llllgt/openhand-t42-structural-design/docs/工程来源.md

# 工程来源与参数依据

查阅日期：2026-10-26。原始 STEP、来源版本与新增研究参数分开记录。没有把网页中其他配置的产品性能直接当作本项目性能。

| 来源 | 本项目使用的信息 | 引用位置 |
|---|---|---|
| [Yale T42](https://www.eng.yale.edu/grablab/openhand/model_t42.html) | 双指、独立驱动及可选机构版本 | 机构对象 |
| [T42 1.0 装配指南](https://www.eng.yale.edu/grablab/openhand/model%20t42/Fabrication%20-%20Model%20T42%201.0.pdf) | 支座/指节关系、6.35 mm 销及卷线件安装；PDF 第 9–14、18 页 | 上部装配、走线假设 |
| [Finger Guide](https://www.eng.yale.edu/grablab/openhand/OpenHand%20Finger%20Guide.pdf) | 腱绳单向驱动、回位元件、不同销孔后加工用途 | 机构及工艺 |
| [CAD Guide](https://www.eng.yale.edu/grablab/openhand/OpenHand%20CAD%20Guide.pdf) | 名义近/远杆长 62.5/37.5、传动半径 8、打印补偿概念 | 名义参数；近端杆长另由 STEP 核对 |
| [ROBOTIS MX-28](https://emanual.robotis.com/docs/en/dxl/mx/mx-28/) | 12 V 堵转转矩 2.5 N·m、空载转速 55 rpm；二者不是持续带载额定值 | 候选规格核对 |
| [EOS PA2200 Balance](https://www.eos.info/polymer-solutions/data-sheets/pds-pa-2200-balance) | 干态模量、方向相关试样强度、密度 | 材料路线与新增 FE 的 E 值参考 |
| [Prusament PETG 数据表](https://storage.googleapis.com/prusa3d-content-prod-14e8-wordpress-prusament-prod/2023/10/9f8d2165-tds_prusament-petg_n_en.pdf) | 试样模量、密度及与打印条件相关的限制 | 试块与装配样件材料比较 |

本地查阅用的三份 Yale PDF 下载至 `E:/Codex/downloads/openhand-reference`，不把外部完整文档复制进发布仓库。校验值：

| 本地文件 | SHA-256 |
|---|---|
| t42-assembly.pdf | bbc0f198c3fa30a37c703ab408299d73618d76459fed0337bd78c9f26cb46719 |
| finger-guide.pdf | 9a18d65482ab79757810bedcfe1d9b31c045f5618501b047b8b66b2d0a48b105 |
| cad-guide.pdf | ede1a6f447741767c93c3a924a36c4e789cd69b2b885e2a643f10128c9546cdd |

关键 STEP 的固定上游提交：`b10197dcd79e7bcfa92c6d5a0bfa479e6a789fba`。源文件 Git blob 哈希见 `source_manifest.json`，原始文件校验见 `upstream_checksums.json`。

本项目自行设定、不可冒充原装或实测参数的项目：接触位置/法向与闭合约束、等效弹簧刚度、传动效率、目标接触力、载荷系数、成品公差、弹性支承刚度、泊松比和验收阈值。完整输入见 `engineering.json`。

原始与派生 CAD 继续保留 Yale OpenHand 的署名及 CC BY-NC 3.0 要求。源机构与新增分析/改型的责任边界见仓库 README 与许可文件。
