llllgt/openhand-t42-structural-design/docs/设计与验证说明.md

# T42 手指支承顶板：设计与验证说明

> 本文件保留 **Rev A 初版** 的参数与结果。当前 **Rev B** 已增加机构/传力分析、装配与公差修订、材料工艺方案及新的等效载荷计算。现行入口见 [机构与传力分析](机构与传力分析.md)、[装配公差与工艺](装配公差与工艺.md) 和 [新增结构验证](新增结构验证.md)。Rev B 顶板体积减少约 5.07%；下文的 1.8 mm / 5.53% 仅属于旧版。

本项目独立于四自由度机械臂项目。交付对象为 OpenHand T42 的一个承载零件及其数值验证，不宣称重新设计了整套欠驱动手。

## 设计输入

- 上游：Yale OpenHand / grablab/openhand-hardware。
- 固定版本：`b10197dcd79e7bcfa92c6d5a0bfa479e6a789fba`。
- 原始零件：`model t42/step/a1_p_t42.STEP`，即 Pivot-Flexure / Pivot-Pivot 手指方案共用的顶板。其来源与装配用途可对照官方 T42 1.0 装配指南第 10 页内容（PDF 第 11 页）。
- 原始零件包围盒 109 × 88 × 9 mm，中央底板名义厚度 3 mm。原 STEP 下表面为 Z = -2.997 mm，中央上表面为 Z = 0.003 mm；保留这个原始坐标偏移。
- 原始 STEP 孔、配合槽和外周定位结构保留；修改只在中央 X ±13 mm、Y ±29 mm 范围内去除材料。通过布尔差验证范围外移除体积为零，新增体积为零。

## 方案取舍

中央区域设置四个 10 × 24 mm、平面角 R2 的凹槽，中心为 (±7, ±16) mm，朝原底面开口。X 方向保留 4 mm 中央连接带，Y 方向保留 8 mm 中央连接带。考察深度 1.0、1.8、2.4 mm，分别保留 2.0、1.2、0.6 mm 底厚。

1.2 mm 最小底厚和 10% 最大柔度增加是本项目预设的设计筛选规则，不是已通过实物验证的生产标准。2.4 mm 方案因剩余底厚过小，在几何筛选阶段排除。1.0 mm 为保守备选，1.8 mm 为重点验证候选。

凹槽不增加包络，可减少新增几何干涉风险；这不等于完成了整个手指机构的运动干涉检查。减去材料可能削弱局部刚度，也可能改变打印支撑、翘曲与装配表现，需要验证。

## 三种参考载荷

顶板上四条座面位于 Z = 0.003 mm，每条宽约 4 mm、长 31.9 mm。两侧座面中心 X 为 ±18.85、±43.75 mm。使用实际 STEP 座面上的面积分布载荷，而非将力施加在一个节点。

| 工况 | 施加方式 | 用途 |
|---|---|---|
| V：竖向 | 每侧两条座面合计 -10 N，整板 -20 N | 参考竖向承载 |
| S：撑开 | 左侧 -10 N X，右侧 +10 N X | 参考平面内传力 |
| M：相反弯矩 | 每侧内外座面施加 ±(500/24.9) N 的 Z 向力偶 | 每侧约 500 N·mm、左右方向相反的参考弯矩 |

四处安装孔的圆柱壁全固定，孔中心 (±23, ±35) mm，源模型孔半径为 2.2479 mm。该边界代表理想刚性夹紧，未包含螺钉预紧、支柱柔性、孔隙或摩擦接触。孔位和孔径源自 STEP 几何，不能把原模型孔径当作已确定的加工公差。

这些载荷是零件级对比工况，不是通过完整腱绳-手指静力学推导得到的工况。特别是 500 N·mm 不能直接换算为整手的额定抓取力或负载能力。

## 材料与求解方法

- 假定均质、各向同性、线弹性聚合物：E = 2000 MPa，泊松比 0.35，密度 1.20 g/cm³。
- 这些参数是比较方案的统一假设，不是任何具体打印牌号或方向的实测参数。几何体积变化可靠；质量为全实体同密度估算，不能视为打印机切片后的用料或称量结果。
- CAD：CadQuery / OpenCascade。网格：Gmsh。有限元：scikit-fem 二次四面体位移单元（P2），在一阶直边几何上计算；线性系统由 SciPy 求解。
- 初步一阶四面体计算显示薄壁弯曲结果对网格敏感，所以最终报告使用二次单元，保留较粗及细化两档网格对照。
- 梁算例采用端面均布力、全固定根部，与含剪切变形的 Timoshenko 梁公式比较。有限元端面平均挠度以载荷做功除以总力得到。
- 对每次求解检查自由自由度残差、总力平衡、总力矩平衡；保留网格、角点位移和单元平均等效应力的数据。

报告中的“最大位移”限定为网格角点采样最大值。应力图显示单元内积分得到的平均 von Mises 应力；表中的最大单元值并不等于连续应力场的峰值。固定孔边缘和几何尖角可能出现应力奇异性，不能用局部峰值推导材料安全系数。

柔度采用 C = Fᵀu（单位 N·mm），对比在同工况下使用 C_new/C_base - 1。该量衡量载荷方向上的整体变形代价；其倒数变化才对应等效刚度变化，不把柔度增加直接写成相同百分比的刚度下降。

## 工艺与图纸

修改图说明凹槽位置、尺寸、圆角、深度和剩余底厚，未修改细节以原始 STEP 为准。凹槽深度初拟为 1.8 mm（上偏差 0，下偏差 -0.15 mm），并要求检验实际剩余底厚不小于 1.2 mm；其他非配合凹槽尺寸初拟 ±0.15 mm。原始底板厚度的制造偏差也必须计入，不能只测凹槽深度。这些公差需要制造验证，不能由 CAD 精度替代。

当前没有选定材料牌号、打印方向、填充率和完整后处理工艺，因此图纸为设计评审图，不能作为生产放行图。STEP 可导入 SolidWorks / Workbench，但本项目没有在这两个软件内重建特征树或执行求解。

## 实物验证建议

制作同批材料、同打印方向的原始与修改件；测量安装孔和定位槽、称重；在相同夹具和载荷下比较座面位移。随后检查反复装拆、腱绳磨损、温升和持续载荷下的蠕变。完成这些步骤后，才能建立实际工艺公差与允许载荷。

## 来源

- [上游仓库](https://github.com/grablab/openhand-hardware)
- [T42 官方页面](https://www.eng.yale.edu/grablab/openhand/model_t42.html)
- [T42 1.0 装配指南](https://www.eng.yale.edu/grablab/openhand/model%20t42/Fabrication%20-%20Model%20T42%201.0.pdf)
- [上游许可](https://github.com/grablab/openhand-hardware/blob/master/LICENSE.md)
