llllgt/openhand-t42-structural-design/docs/新增结构验证.md

# Rev B 新增结构验证

本版的材料、载荷和凹槽深度与 Rev A 不同，结果不得交叉比较。使用二次四面体位移单元和一阶几何。研究输入为 PA2200 参考 E=1650 MPa、假设 ν=0.35；上部机构推导的合力/合矩乘 1.5 后，以四座面等效牵引加载。未求解真实上下板接触分载。

## 刚性支承对照

| 模型 | 体积 mm³ | P2 节点采样最大位移 mm | 柔度 N·mm |
|---|---:|---:|---:|
| 原始 | 30774.924 | 0.482567 | 29.398631 |
| Rev B | 29213.586 | 0.497923 | 30.464589 |

体积减少 **5.07%**；柔度增加 **3.63%**，对应本载荷模式等效刚度变化 **-3.50%**。这不是整手减重或强度提高。

## 网格复核

| 模型 | 粗/细单元数 | 柔度变化 | 全域单元应力最大值变化 | 中央区域单元应力最大值变化 |
|---|---|---:|---:|---:|
| baseline | 17262 / 25458 | 0.660% | 26.32% | -15.14% |
| revB | 21162 / 32069 | 0.588% | 6.11% | 12.37% |

目标网格尺寸 3.0→2.4 mm；柔度变化上限按百分比向上保留两位，报告为 **≤0.66%**。局部应力指标没有同等稳定，不能据此声称峰值应力收敛或强度已达标。保留应力数据用于定位和后续验证，不给安全系数。中央区域仅按单元中心 |X|<13、|Y|<29 定义，不是人为选出的“已通过”强度区域。

## 支承敏感性

| 支承 | P2 节点采样最大位移 mm | 柔度 N·mm | 相对刚性支承柔度增幅 |
|---|---:|---:|---:|
| 孔壁全固定 | 0.497923 | 30.464589 | 0.00% |
| 孔壁弹性支承 k=100.0 N/mm³ | 0.809434 | 47.044221 | 54.42% |
| 孔壁弹性支承 k=10.0 N/mm³ | 1.272445 | 71.599843 | 135.03% |

弹性支承采用孔壁三向分布弹簧：K_total=K_solid+∫k NᵀN dA。k=100/10 是探索边界敏感性的假设值，没有映射为某个真实螺钉或支柱。柔度差异说明支承模型对绝对变形影响很大；不能把全固定结果当成未经校准的实物预测。弹性支承工况只计算 Rev B，不把它与全固定原始件作改型优劣比较。

固定边界、相同泊松比下，线弹性位移随 1/E 缩放。E=1000–2200 MPa 的敏感性值也列入摘要；这个解析缩放只用于固定边界，不套用到材料与支承相对刚度同时改变的情形。

## 检查与数据定义

每个算例验证了：左右分区合力/合矩、总力与总力矩平衡、自由度残差，以及外力功/2=实体应变能+支承弹簧能。二次节点最大值包含顶点与边中点，仍是节点采样，不是连续位移场极值的严格证明。云图只绘制角点位移，明确标注。

应力值为单元积分平均值；圆角、凹槽交线、固定边界及载荷转换区可能产生强梯度。未建立完整材料许用值、螺栓预紧或疲劳模型。销轴/耳板另做解析需求筛查，见装配公差文档。

原始六组网格、位移和应力数组在 `results/engineering/fea/raw-revB.zip`，SHA-256 见同目录 `raw_checksums.json`。结果摘要与全部假设见 `results/engineering/summary.json`。该报告明确记录不确定性，而不是以应力云图代替验证结论。
