llllgt/openhand-t42-structural-design/assets/boundary_conditions.png

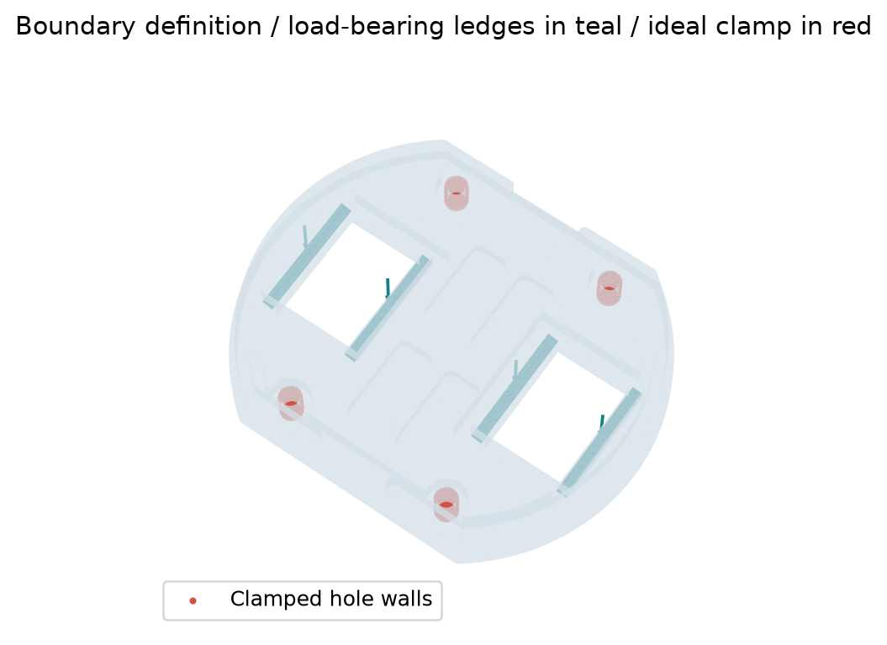
assets/boundary_conditions.png
