llllgt/openhand-t42-structural-design/assets/design_comparison.png

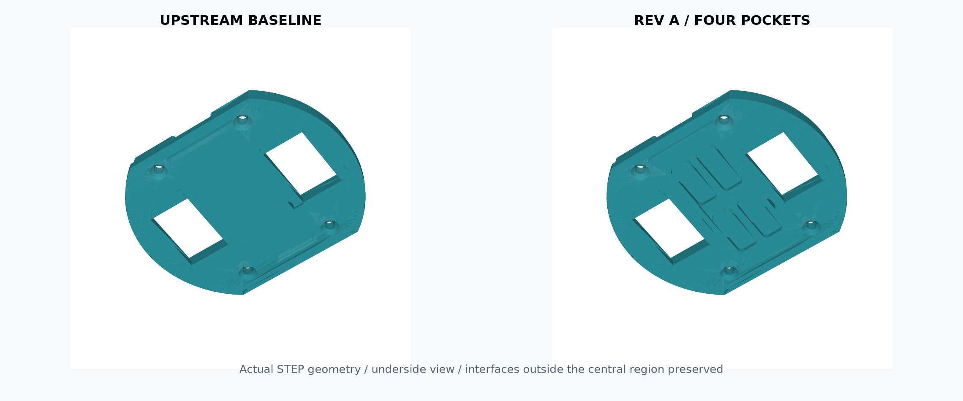
assets/design_comparison.png
