llllgt/openhand-t42-structural-design/assets/displacement_field.png

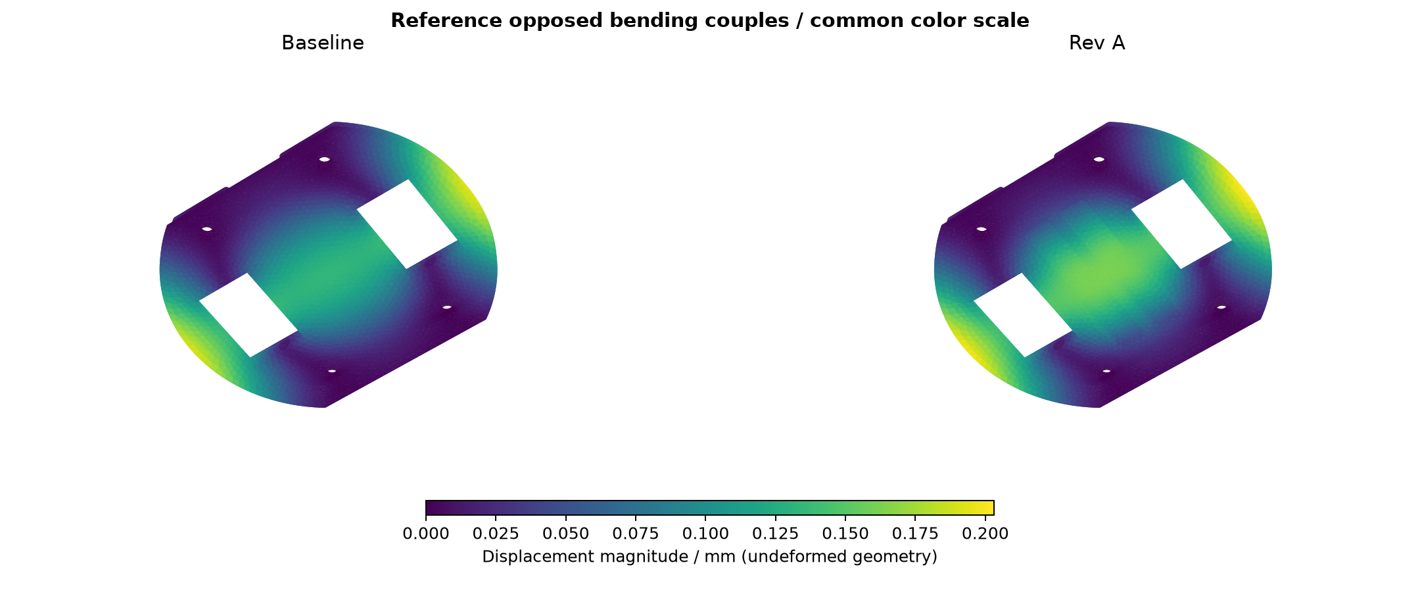
assets/displacement_field.png
