llllgt/openhand-t42-structural-design/assets/engineering_displacement.png

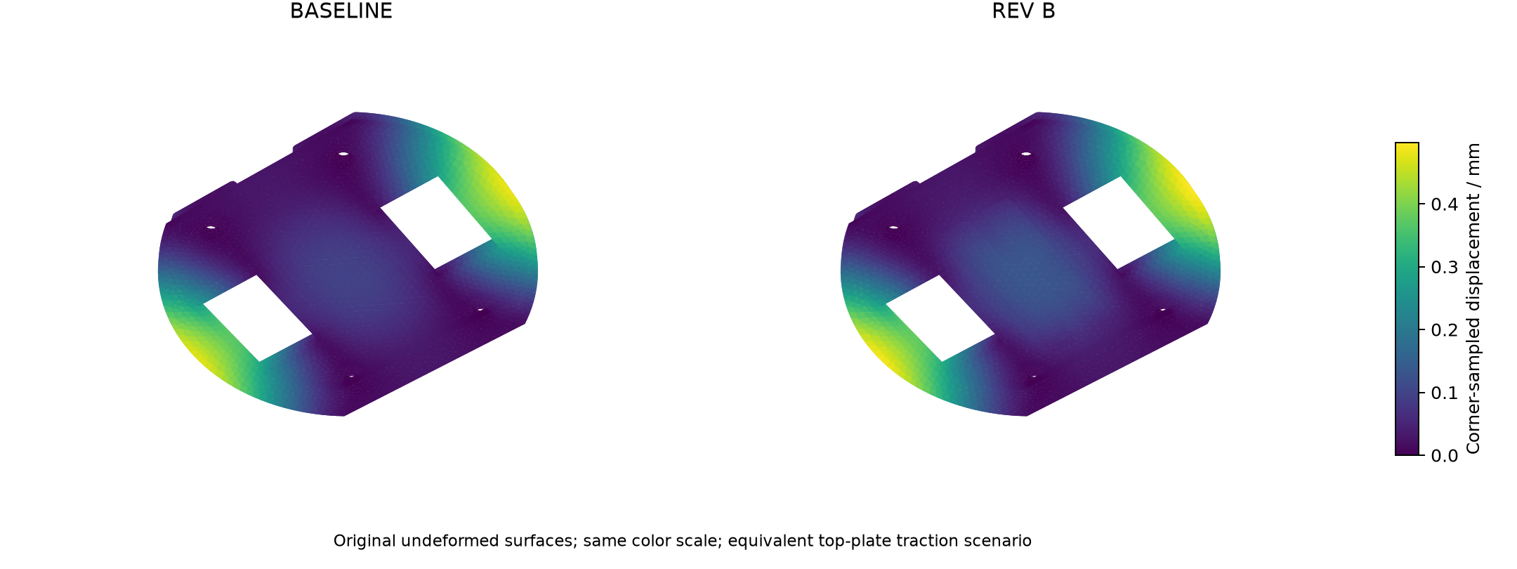
assets/engineering_displacement.png
