llllgt/openhand-t42-structural-design/assets/fea_comparison.png

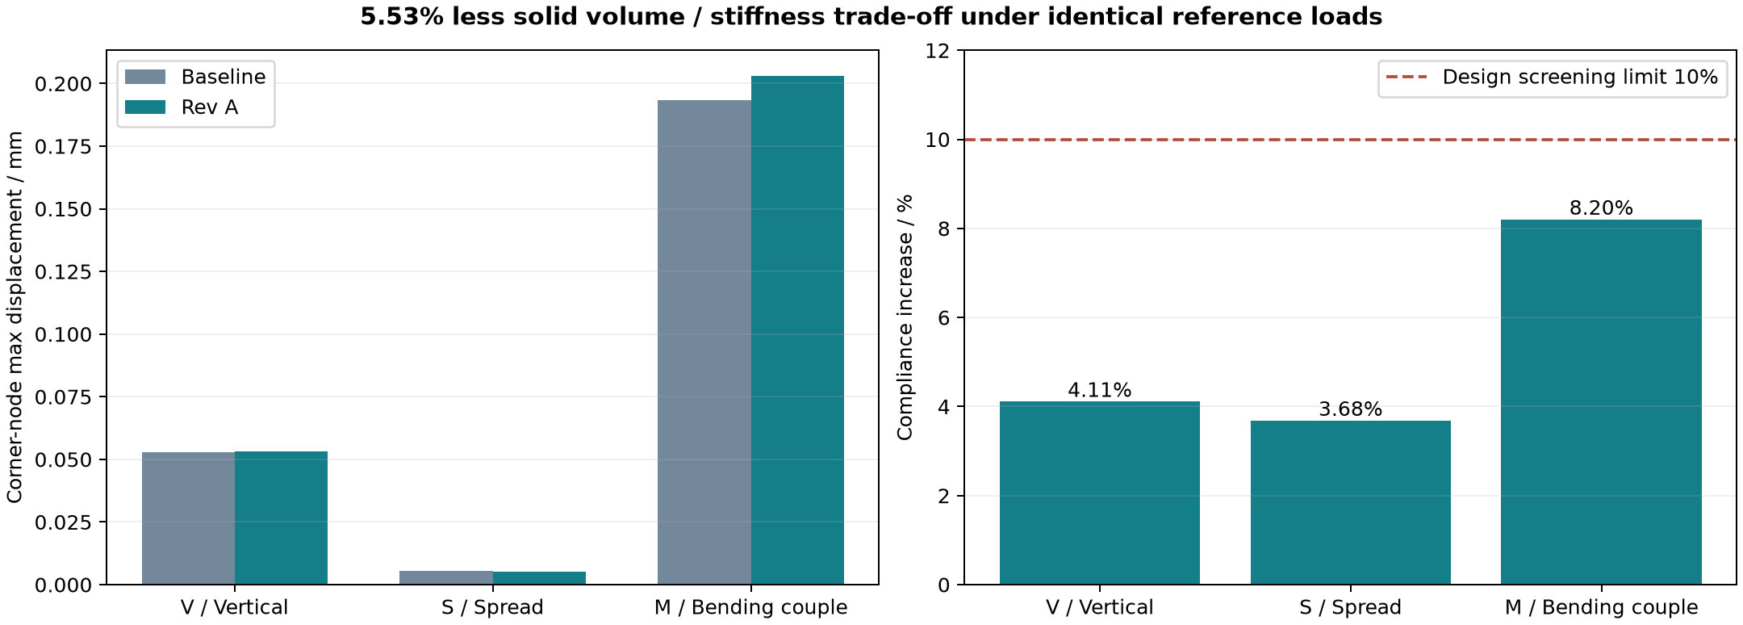
assets/fea_comparison.png
