llllgt/openhand-t42-structural-design/assets/modification_drawing.png

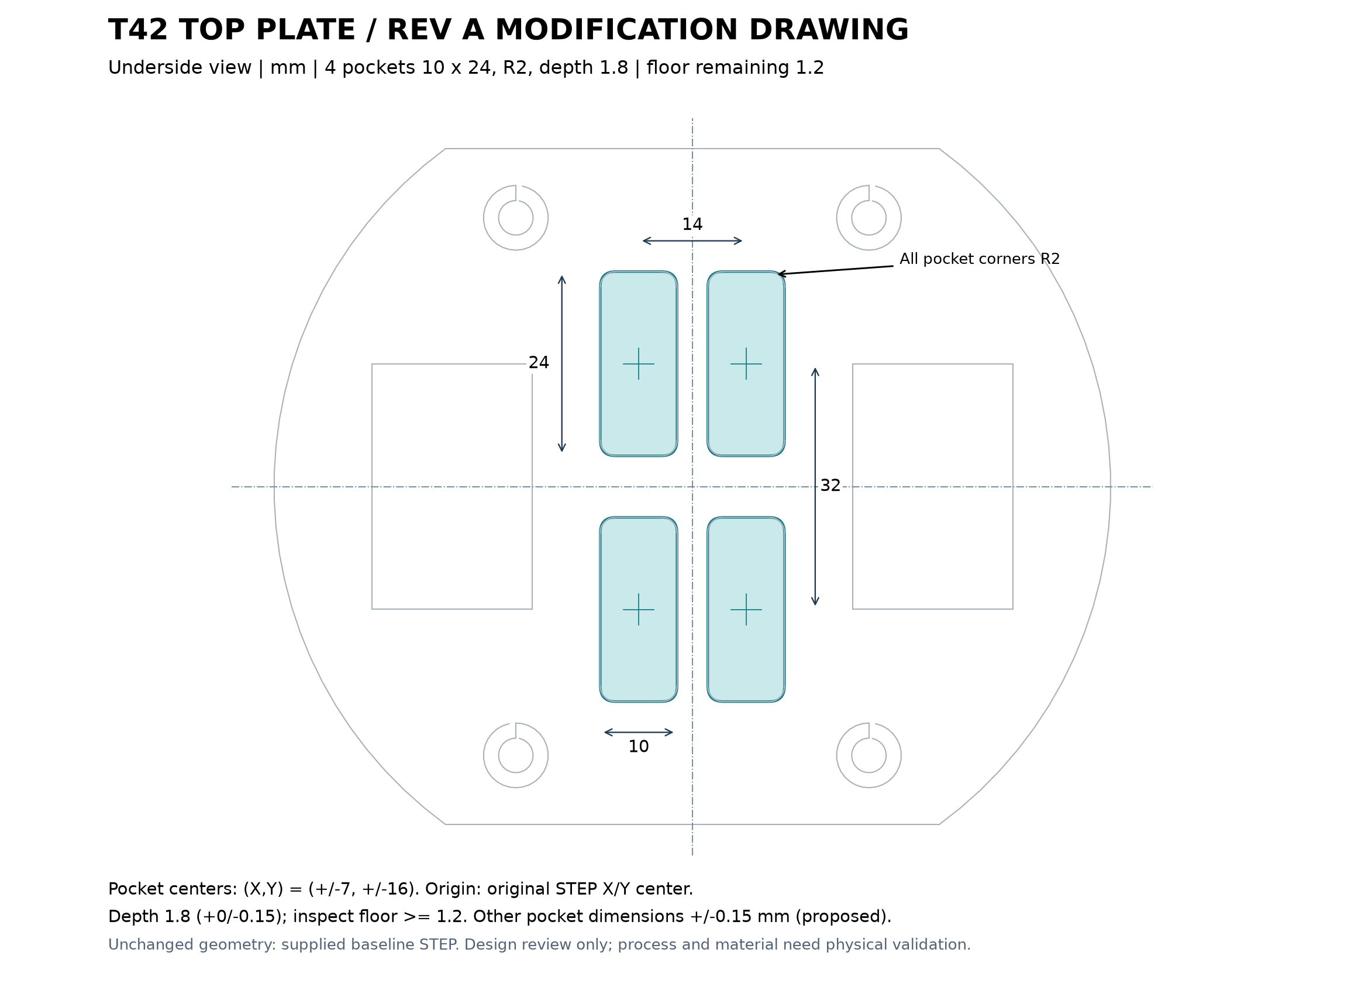
assets/modification_drawing.png
