llllgt/openhand-t42-structural-design/docs/机械件清单.md

# 上部组件机械件与选型清单（Rev B）

这是本项目数字模型涉及的上部组件及驱动接口清单，不是完整采购 BOM。执行器下部外壳、支柱、控制器和连接线沿用上游方案，未在此次上部装配模型中重建；标准件的材质、精度与在售状态需采购前确认。

| 项目 | 单套数量 | 文件或要求 | 状态 |
|---|---:|---|---|
| 支承顶板 | 1 | cad/engineering/top_plate_revB.step | Rev B，1.65 mm 四凹槽 |
| 指根支座 | 2 | cad/engineering/bracket_revB.step | 外宽 31.60，固定孔成品中值 6.3325 |
| 近指节 | 2 | cad/engineering/finger_A_finished.step | 根部旋转孔、远端固定孔分开定义 |
| 远指节 | 2 | cad/engineering/finger_B_finished.step | 旋转孔成品中值 6.3875 |
| 孔径校准试块 | 每工艺/批次至少 1 | cad/engineering/pin_fit_coupon.step | 工艺件，不装入夹爪 |
| 近、远关节销 | 4 | 名义 1/4 in；本项目拟按实测直径 6.344–6.350 选配 | 材质、直线度及长度仍需到货核对 |
| 支座底部转向销 | 2 | 上游 1/4 in 钢销方案 | 不与近端关节销重复计数 |
| 指节走线销 | 4 | 上游 1/8 in 钢销方案 | 表面质量、穿绳余隙与磨损待验证 |
| 近端回位元件 | 2 | 工作范围内等效 20 N·mm/rad 为研究目标 | 未选定并验证具体拉簧/扭簧型号 |
| 远端回位元件 | 2 | 工作范围内等效 40 N·mm/rad 为研究目标 | 实际锚点力臂、预紧与非线性需标定 |
| 腱绳 | 2 路 | 研究直径 0.5 mm、非弹性近似 | 实际直径、损耗、打结强度与磨损待验证 |
| 驱动器 | 2 | MX-28，需求计算见机构文档 | 兼容性候选，未完成持续工况放行 |
| 卷线件 | 2 | cad/upstream/b1_dynamixel_t42.STEP | 保留上游；槽底半径由 STEP 核对 |
| 接触垫及锚固件 | 随两指配置 | 沿用上游制作说明 | 未纳入本次刚体干涉模型和材料标定 |

原始、收拢中间、目标姿态三个 STEP 是同一套零件的不同数字姿态，不能把三个装配文件累计为三套物料。成品 CAD 与打印毛坯必须分开管理，按孔径试块结果确定补偿，不能将精配合成品孔直接作为未经验证的打印输入。
