llllgt/openhand-t42-structural-design/cad/engineering/revB_upper_q15_15.step

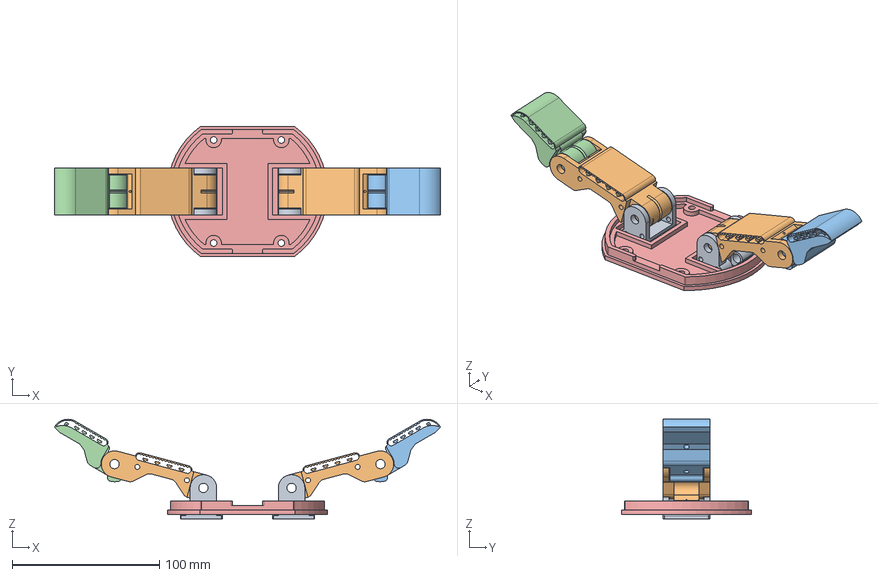
[picture p17: CAD file, 2026-10-26]
cad/engineering/revB_upper_q15_15.step
262.2 x 88.0 x 67.6 mm
mount_R
proximal_R
distal_R
mount_L
proximal_L
distal_L
plate
