llllgt/openhand-t42-structural-design/cad/upstream/b1_dynamixel_t42.STEP

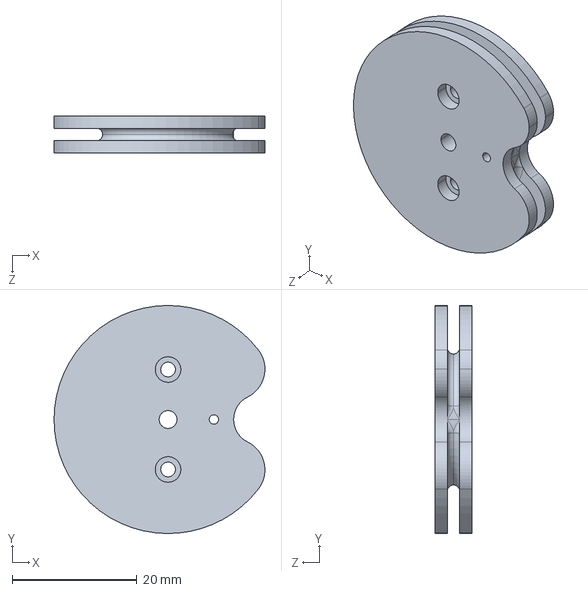
[picture p18: CAD file, 2026-10-26]
cad/upstream/b1_dynamixel_t42.STEP
33.8 x 36.5 x 6.00 mm
