llllgt/openhand-t42-structural-design/cad/variants/baseline.step

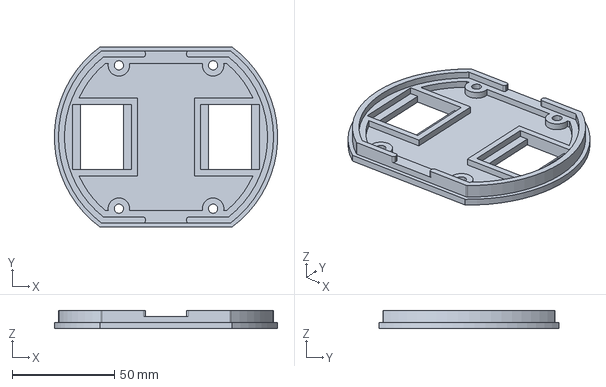
[picture p19: CAD file, 2026-10-26]
cad/variants/baseline.step
108.9 x 88.0 x 9.00 mm
