llllgt/openhand-t42-structural-design/cad/engineering/revB_upper_q55_90.step

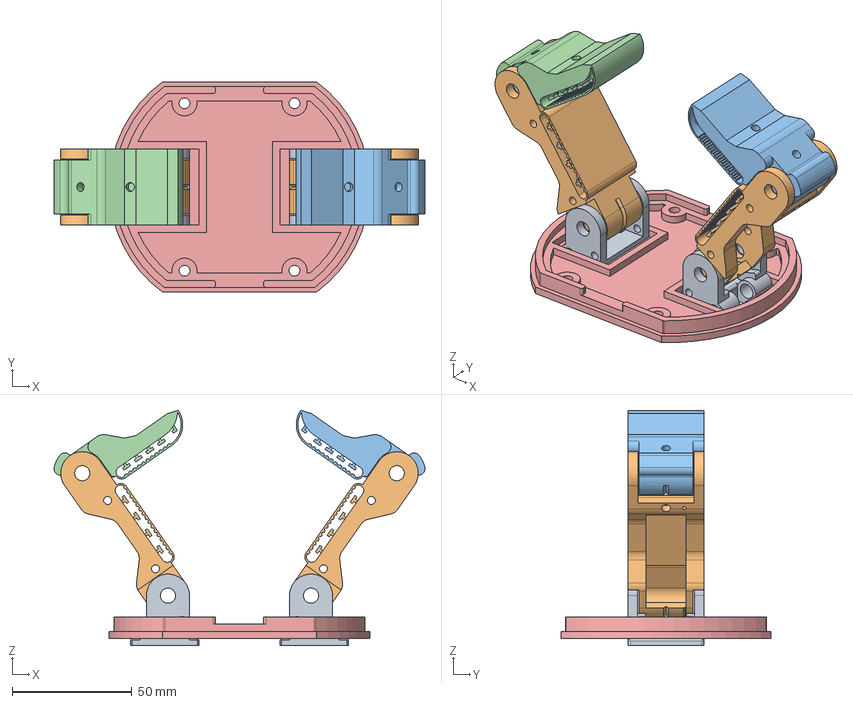
[picture p20: CAD file, 2026-10-26]
cad/engineering/revB_upper_q55_90.step
155.2 x 88.0 x 98.4 mm
mount_R
proximal_R
distal_R
mount_L
proximal_L
distal_L
plate
