llllgt/openhand-t42-structural-design/cad/upstream/finger_pp_B_t42.STEP

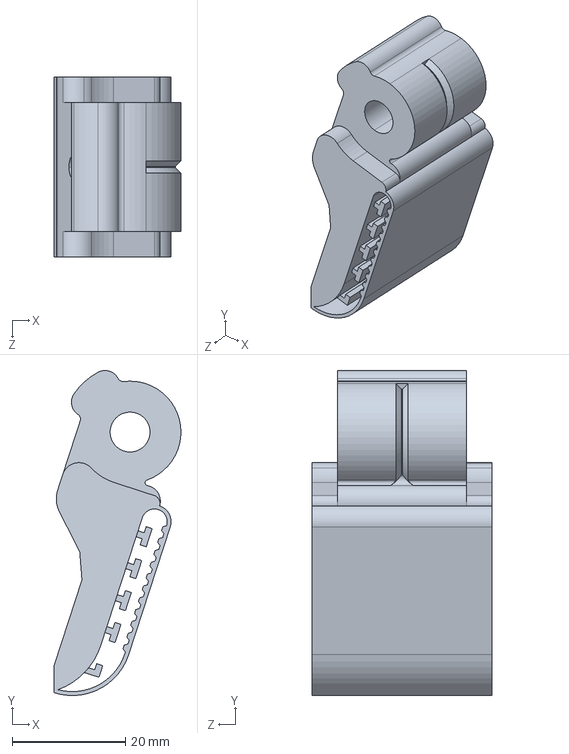
[picture p21: CAD file, 2026-10-26]
cad/upstream/finger_pp_B_t42.STEP
22.4 x 57.5 x 31.8 mm
