llllgt/openhand-t42-structural-design/cad/engineering/bracket_revB.step

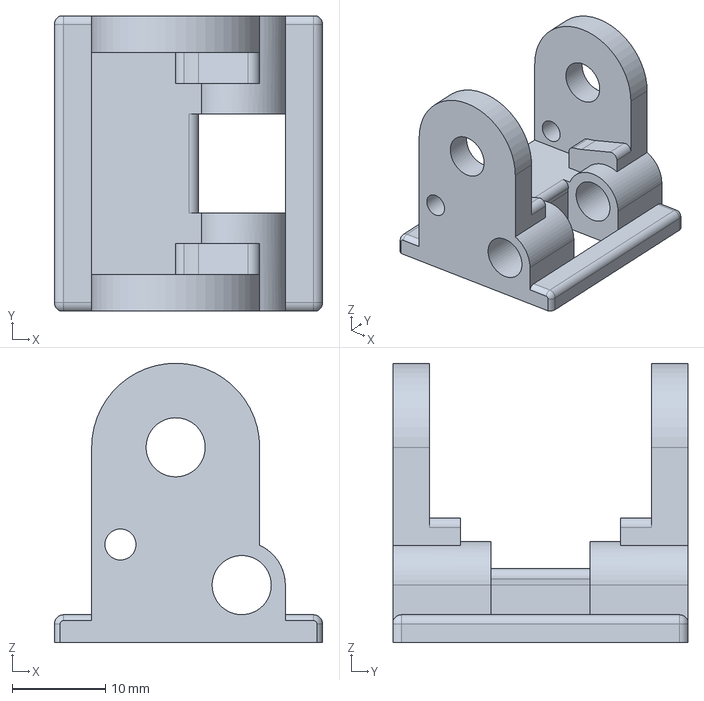
[picture p22: CAD file, 2026-10-26]
cad/engineering/bracket_revB.step
28.7 x 31.6 x 29.9 mm
