llllgt/openhand-t42-structural-design/cad/engineering/revB_upper_q55_35.step

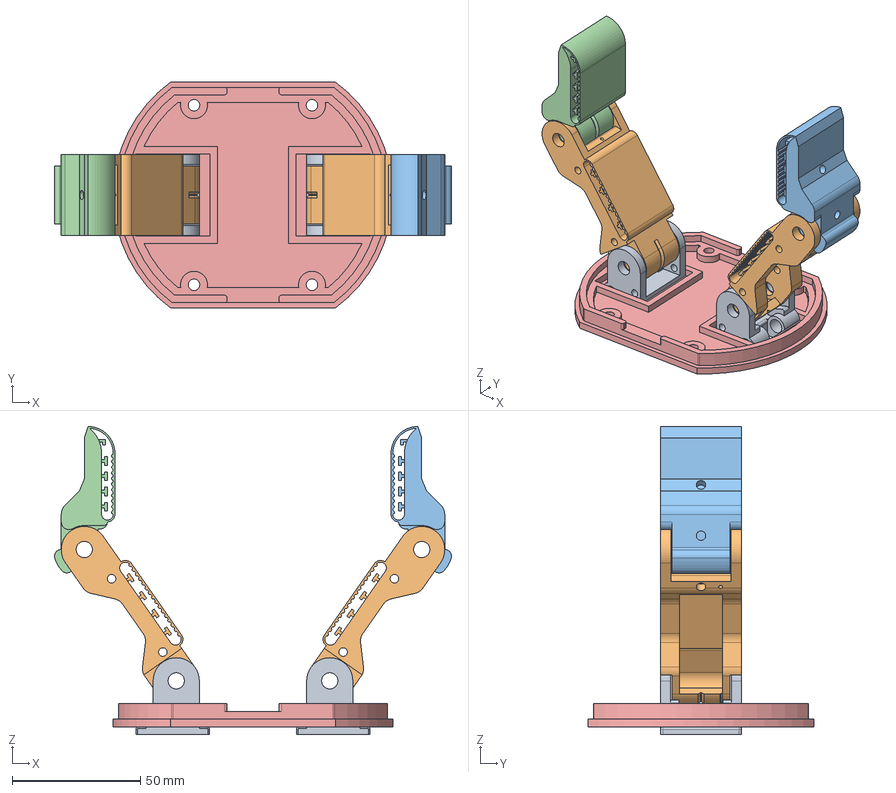
[picture p23: CAD file, 2026-10-26]
cad/engineering/revB_upper_q55_35.step
154.8 x 88.0 x 120.1 mm
mount_R
proximal_R
distal_R
mount_L
proximal_L
distal_L
plate
