llllgt/openhand-t42-structural-design/cad/upstream/finger_pp_ext_A_t42.STEP

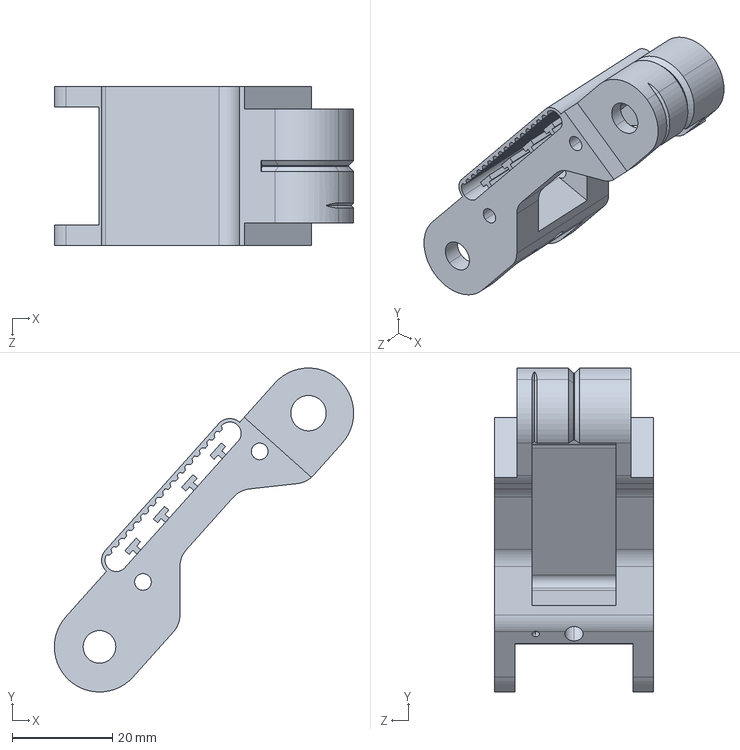
[picture p24: CAD file, 2026-10-26]
cad/upstream/finger_pp_ext_A_t42.STEP
59.7 x 64.6 x 31.8 mm
