llllgt/openhand-t42-structural-design/cad/engineering/pin_fit_coupon.step

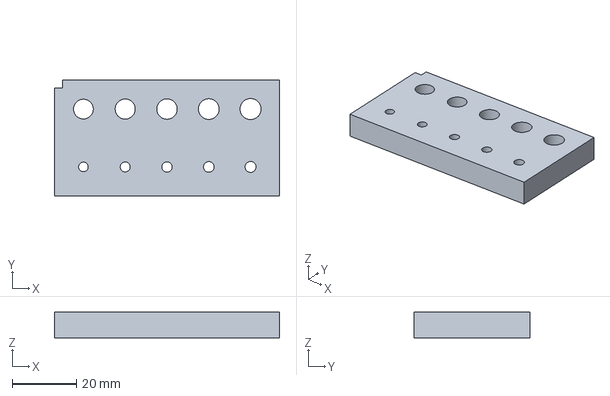
[picture p25: CAD file, 2026-10-26]
cad/engineering/pin_fit_coupon.step
70.0 x 36.0 x 8.00 mm
