llllgt/openhand-t42-structural-design/(list of files, cad)

Other CAD files:
cad/variants/pocket_1p0.step
cad/upstream/c1_t42.STEP
cad/variants/pocket_2p4.step
cad/variants/pocket_1p8.step
cad/engineering/top_plate_revB.step
cad/upstream/a1_p_t42.STEP
cad/engineering/finger_A_finished.step
cad/engineering/finger_B_finished.step
cad/engineering/bracket_revB.stl
cad/engineering/finger_A_finished.stl
cad/engineering/finger_B_finished.stl
cad/engineering/pin_fit_coupon.stl
cad/engineering/top_plate_revB.stl
cad/variants/baseline.stl
cad/variants/pocket_1p0.stl
cad/variants/pocket_1p8.stl
cad/variants/pocket_2p4.stl
