llllgt/openhand-t42-structural-design/results/comparison.csv

case | baseline_corner_max_mm | modified_corner_max_mm | baseline_compliance_Nmm | modified_compliance_Nmm | compliance_increase_percent | equivalent_stiffness_change_percent | baseline_p95_vm_MPa | modified_p95_vm_MPa
vertical_20N | 0.052760545362836565 | 0.0531629184196602 | 0.8077578111765364 | 0.8409323549573897 | 4.106991392944015 | -3.9449717430047326 | 0.43431124502384116 | 0.4685640896630453
spread_10N_each | 0.00534788789806877 | 0.005245303611626424 | 0.03456479425748623 | 0.03583715036701047 | 3.681075316248017 | -3.550383042440486 | 0.08624988294695671 | 0.09269892318838145
opposed_500Nmm | 0.1933373757216465 | 0.20310049753665882 | 9.764149809714956 | 10.564620761039079 | 8.198060936423612 | -7.5769019014497285 | 1.415086807095031 | 1.515291938586402
