llllgt/openhand-t42-structural-design/results/engineering/closure_path.csv

tension_N | q1_deg | q2_deg | N1_N | N2_N | stage | tendon_take_up_mm
0.0 | 14.999999999999998 | 14.999999999999998 | 0.0 | 0.0 | free | 0.0
0.22169984694978737 | 20.08098621956764 | 17.54049310978382 | 0.0 | 0.0 | free | 1.0641592653589793
0.44339969389957473 | 25.16197243913529 | 20.08098621956764 | 0.0 | 0.0 | free | 2.1283185307179586
0.6650995408493621 | 30.242958658702932 | 22.621479329351466 | 0.0 | 0.0 | free | 3.1924777960769375
0.8867993877991495 | 35.32394487827059 | 25.16197243913529 | 0.0 | 0.0 | free | 4.256637061435918
1.1084992347489369 | 40.40493109783822 | 27.70246554891911 | 0.0 | 0.0 | free | 5.320796326794897
1.3301990816987241 | 45.485917317405864 | 30.242958658702932 | 0.0 | 0.0 | free | 6.384955592153876
1.5518989286485116 | 50.56690353697352 | 32.783451768486756 | 0.0 | 0.0 | free | 7.449114857512857
1.773598775598299 | 55.0 | 35.32394487827059 | 0.0064616053951929535 | 0.0 | proximal_contact | 8.422811647339135
1.9952986225480862 | 55.0 | 37.8644379880544 | 0.057135856126572904 | 0.0 | proximal_contact | 8.777531402458793
2.2169984694978737 | 55.0 | 40.40493109783822 | 0.1078101068579529 | 0.0 | proximal_contact | 9.132251157578454
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
