llllgt/openhand-t42-structural-design/(commit log)

2026-10-26 Add T42 top plate design variants and verified stiffness study
    [a1_p_t42.STEP, baseline.step, baseline.stl, c1_t42.STEP, comparison.csv, finger_pp_B_t42.STEP, finger_pp_ext_A_t42.STEP, pocket_1p0.step]
2026-10-26 Complete revision B mechanism, tolerance and structural design study
    [b1_dynamixel_t42.STEP, bracket_revB.step, bracket_revB.stl, closure_path.csv, finger_A_finished.step, finger_A_finished.stl, finger_B_finished.step, finger_B_finished.stl]
2026-10-27 Remove resume and interview material from technical repository
